markmcgookin/pico-gps-datalogger/Case/Manufacturing/NewSwitchMount.stl

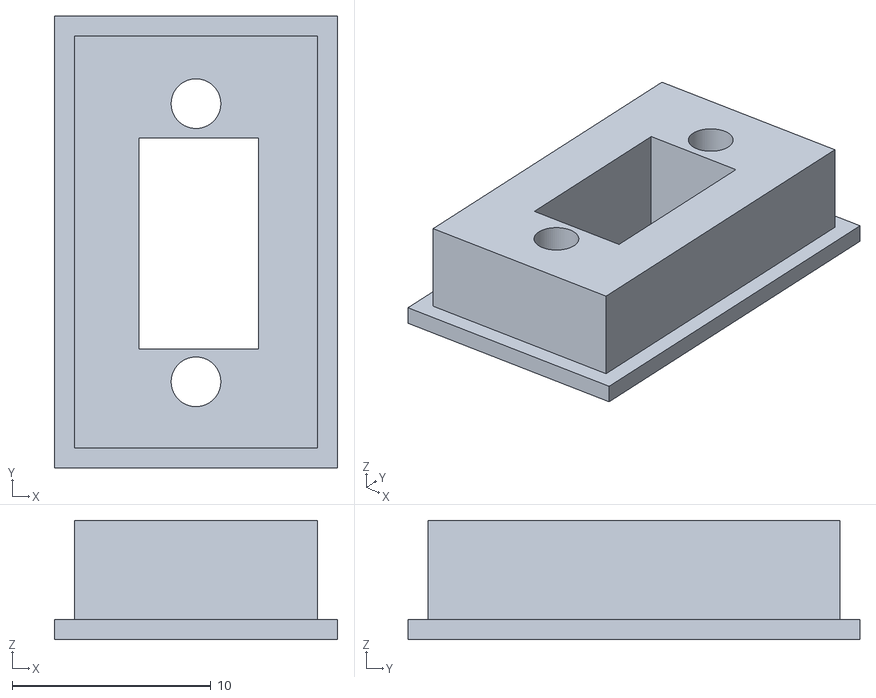
[picture p1: CAD file, 2023-01-19]
Case/Manufacturing/NewSwitchMount.stl
14.2 x 22.8 x 6.00
