markmcgookin/pico-gps-datalogger/Case/Manufacturing/ChargerMount.stl

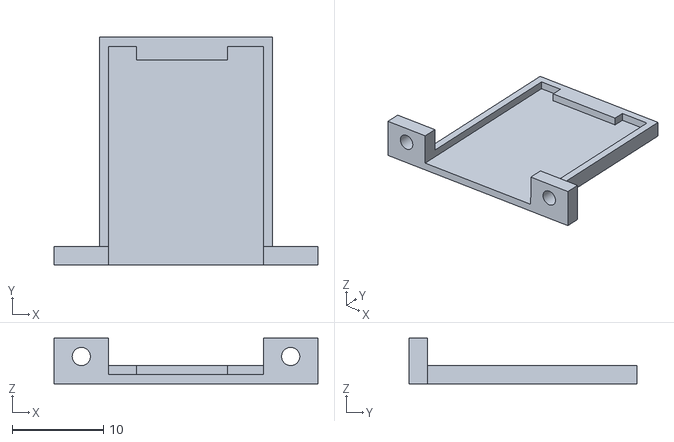
[picture p2: CAD file, 2023-01-19]
Case/Manufacturing/ChargerMount.stl
29.0 x 25.0 x 5.00
