markmcgookin/pico-gps-datalogger/Case/Manufacturing/Lid-Expanded.stl

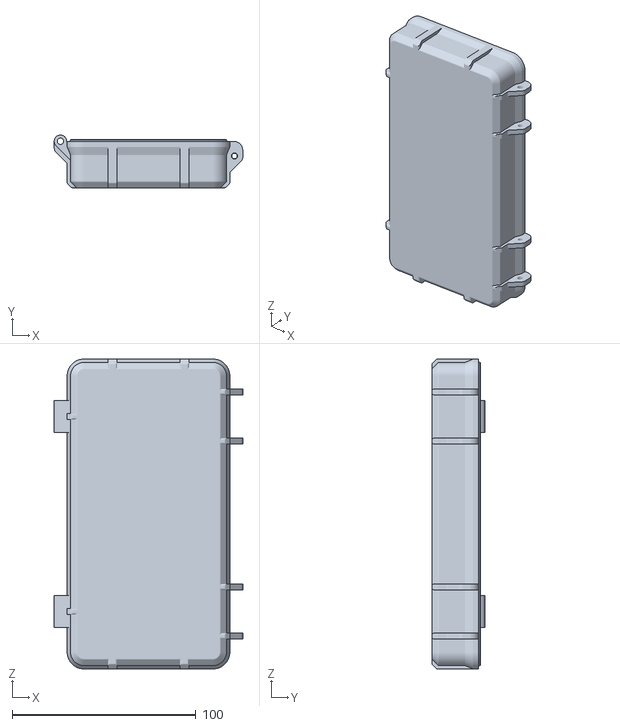
[picture p3: CAD file, 2023-01-19]
Case/Manufacturing/Lid-Expanded.stl
102.5 x 28.8 x 168.5
