markmcgookin/pico-gps-datalogger/Case/Manufacturing/Box-Expanded.stl

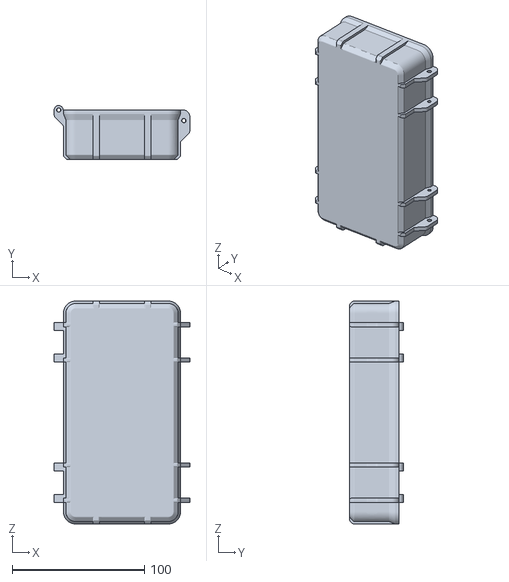
[picture p4: CAD file, 2023-01-19]
Case/Manufacturing/Box-Expanded.stl
102.5 x 40.8 x 168.5
