markmcgookin/pico-gps-datalogger/Case/Manufacturing/Insert-Expanded-PowerSwitch.stl

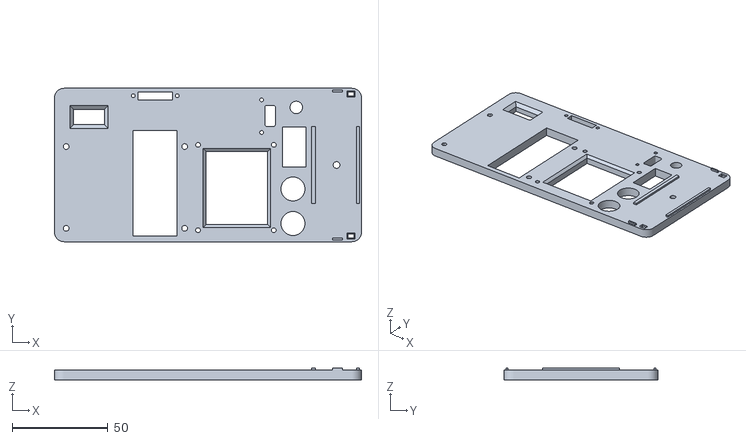
[picture p5: CAD file, 2023-01-19]
Case/Manufacturing/Insert-Expanded-PowerSwitch.stl
160.0 x 80.0 x 6.00
