markmcgookin/pico-gps-datalogger/Case/Manufacturing/Box Latch.stl

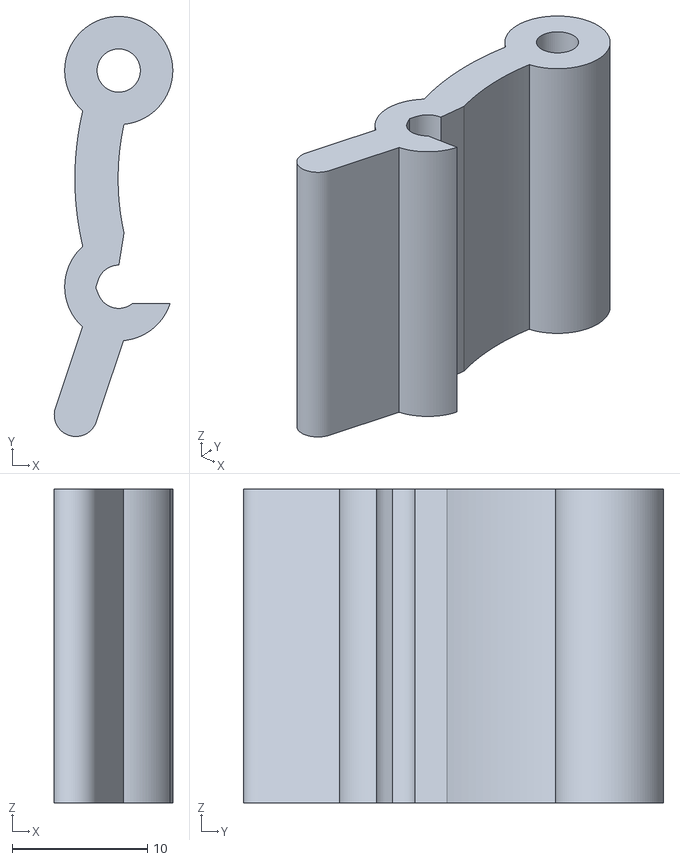
[picture p6: CAD file, 2023-01-19]
Case/Manufacturing/Box Latch.stl
8.77 x 31.1 x 23.2
