markmcgookin/pico-gps-datalogger/(list of files, cad)

Other CAD files:
Case/3D Modeling/Rugged Box v55.f3d
