markmcgookin/pico-gps-datalogger/board-design/pico-gps-datalogger/pico-gps-datalogger.kicad_pcb

## KiCad design board-design/pico-gps-datalogger/pico-gps-datalogger.kicad_pcb (2023-01-01)

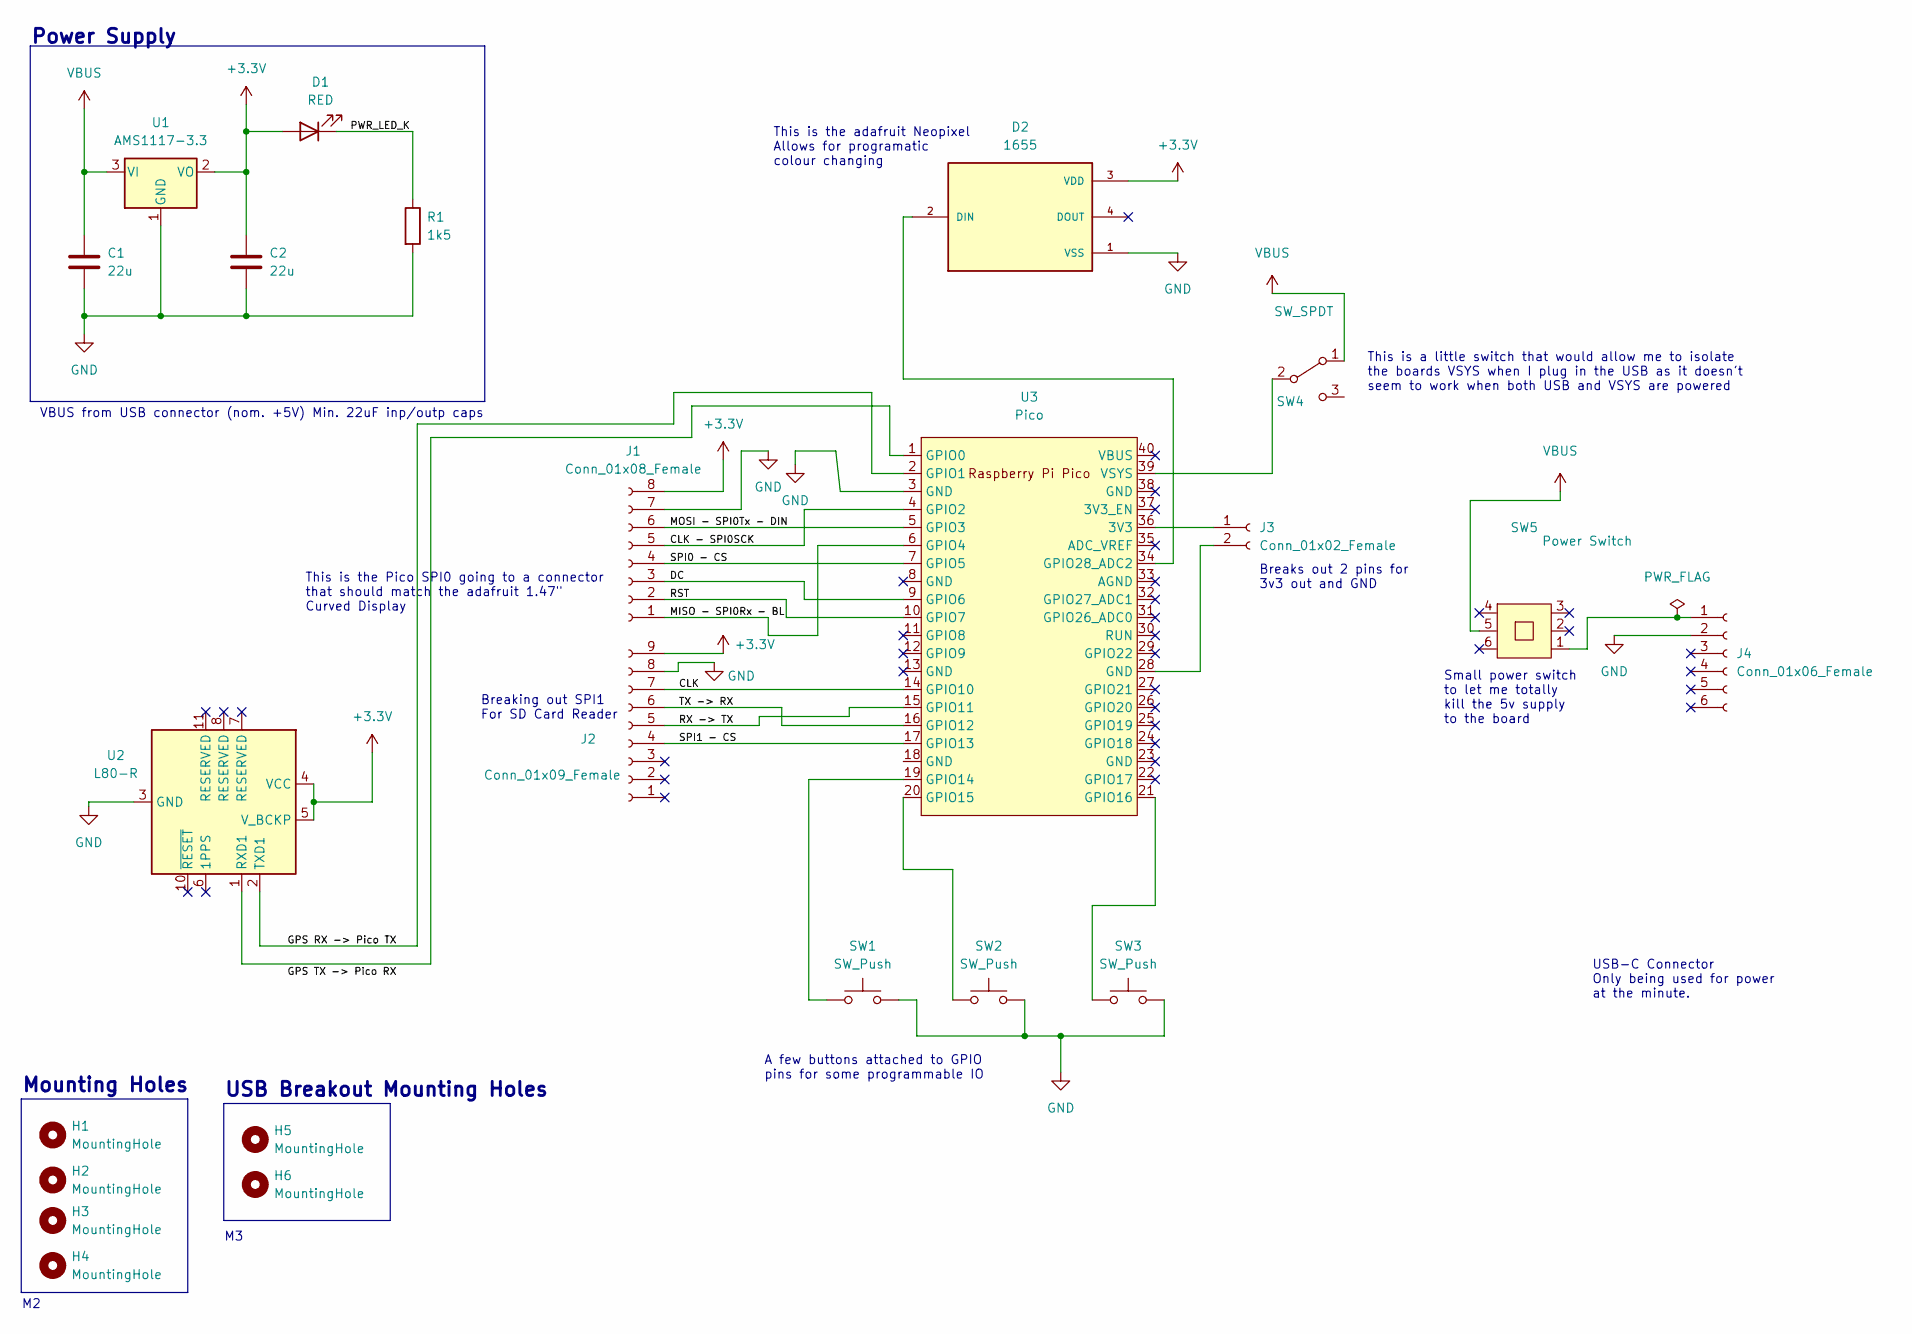
[picture p7: schematic pico-gps-datalogger.kicad_sch, RPI Pico - SPI Display with Neopixel - GPS and SD Card]

Parts:
C1, C2: 22u; C_0603_1608Metric
D1: RED; LED_0603_1608Metric
D2: 1655; LED_1655; PARTREV 01
H1, H2, H3, H4: MountingHole; MountingHole_2.2mm_M2
H5, H6: MountingHole; MountingHole_3.2mm_M3
J1: Conn_01x08_Female; JST_PH_B8B-PH-K_1x08_P2.00mm_Vertical
J2: Conn_01x09_Female; PinHeader_1x09_P2.54mm_Vertical
J3: Conn_01x02_Female; PinHeader_1x02_P2.54mm_Vertical
J4: Conn_01x06_Female; PinHeader_1x06_P2.54mm_Vertical
R1: 1k5; R_0603_1608Metric
SW1, SW2, SW3: SW_Push; SW_PUSH_6mm_H5mm
SW4: SW_SPDT; SW_SPDT_PCM12
SW5: Power Switch; SW_DPDT_XLX
U1: AMS1117-3.3; SOT-223-3_TabPin2
U2: L80-R; Quectel_L80-R
U3: Pico; RPi_Pico_SMD_TH

Connections:
+3.3V: C2.1, D1.2 (A), D2.3 (VDD), J1.8, J2.9, U1.2 (VO), U2.4 (VCC), U2.5 (V_BCKP)
/CLK: J2.7, U3.14 (GPIO10)
/CLK - SPI0SCK: J1.5, U3.4 (GPIO2)
/DC: J1.3, U3.9 (GPIO6)
/GPS RX -> Pico TX: U2.2 (TXD1), U3.2 (GPIO1)
/MISO - SPI0Rx - BL: J1.1, U3.6 (GPIO4)
/MOSI - SPI0Tx - DIN: J1.6, U3.5 (GPIO3)
/PWR_LED_K: D1.1 (K), R1.1
/RST: J1.2, U3.10 (GPIO7)
/RX -> TX: J2.5, U3.15 (GPIO11)
/SPI0 - CS: J1.4, U3.7 (GPIO5)
/SPI1 - CS: J2.4, U3.17 (GPIO13)
/TX -> RX: J2.6, U3.16 (GPIO12)
GND: C1.2, C2.2, D2.1 (VSS), J1.7, J2.8, J4.2, R1.2, SW1.2, SW2.2, SW3.2, U1.1 (GND), U2.3 (GND), U2.12 (GND), U3.3 (GND)
unnamed: D2.2 (DIN), U3.34 (GPIO28_ADC2)
unnamed: J3.1, U3.36 (3V3)
unnamed: J3.2, U3.28 (GND)
unnamed: J4.1, SW5.1
unnamed: SW1.1, U3.19 (GPIO14)
unnamed: SW2.1, U3.20 (GPIO15)
unnamed: SW3.1, U3.21 (GPIO16)
unnamed: SW4.2 (B), U3.39 (VSYS)
unnamed: U2.1 (RXD1), U3.1 (GPIO0)
VBUS: C1.1, SW4.1 (A), SW5.5, U1.3 (VI)

Notes on the sheet:
A few buttons attached to GPIO pins for some programmable IO
Power Supply
Breaks out 2 pins for 3v3 out and GND
Mounting Holes
Small power switch to let me totally kill the 5v supply to the board
USB Breakout Mounting Holes
USB-C Connector Only being used for power at the minute.
Breaking out SPI1 For SD Card Reader
This is the adafruit Neopixel Allows for programatic colour changing
VBUS from USB connector (nom. +5V) Min. 22uF inp/outp caps
This is a little switch that would allow me to isolate the boards VSYS when I plug in the USB as it doesn't seem to work when both USB and VSYS are powered
This is the Pico SPI0 going to a connector that should match the adafruit 1.47" Curved Display

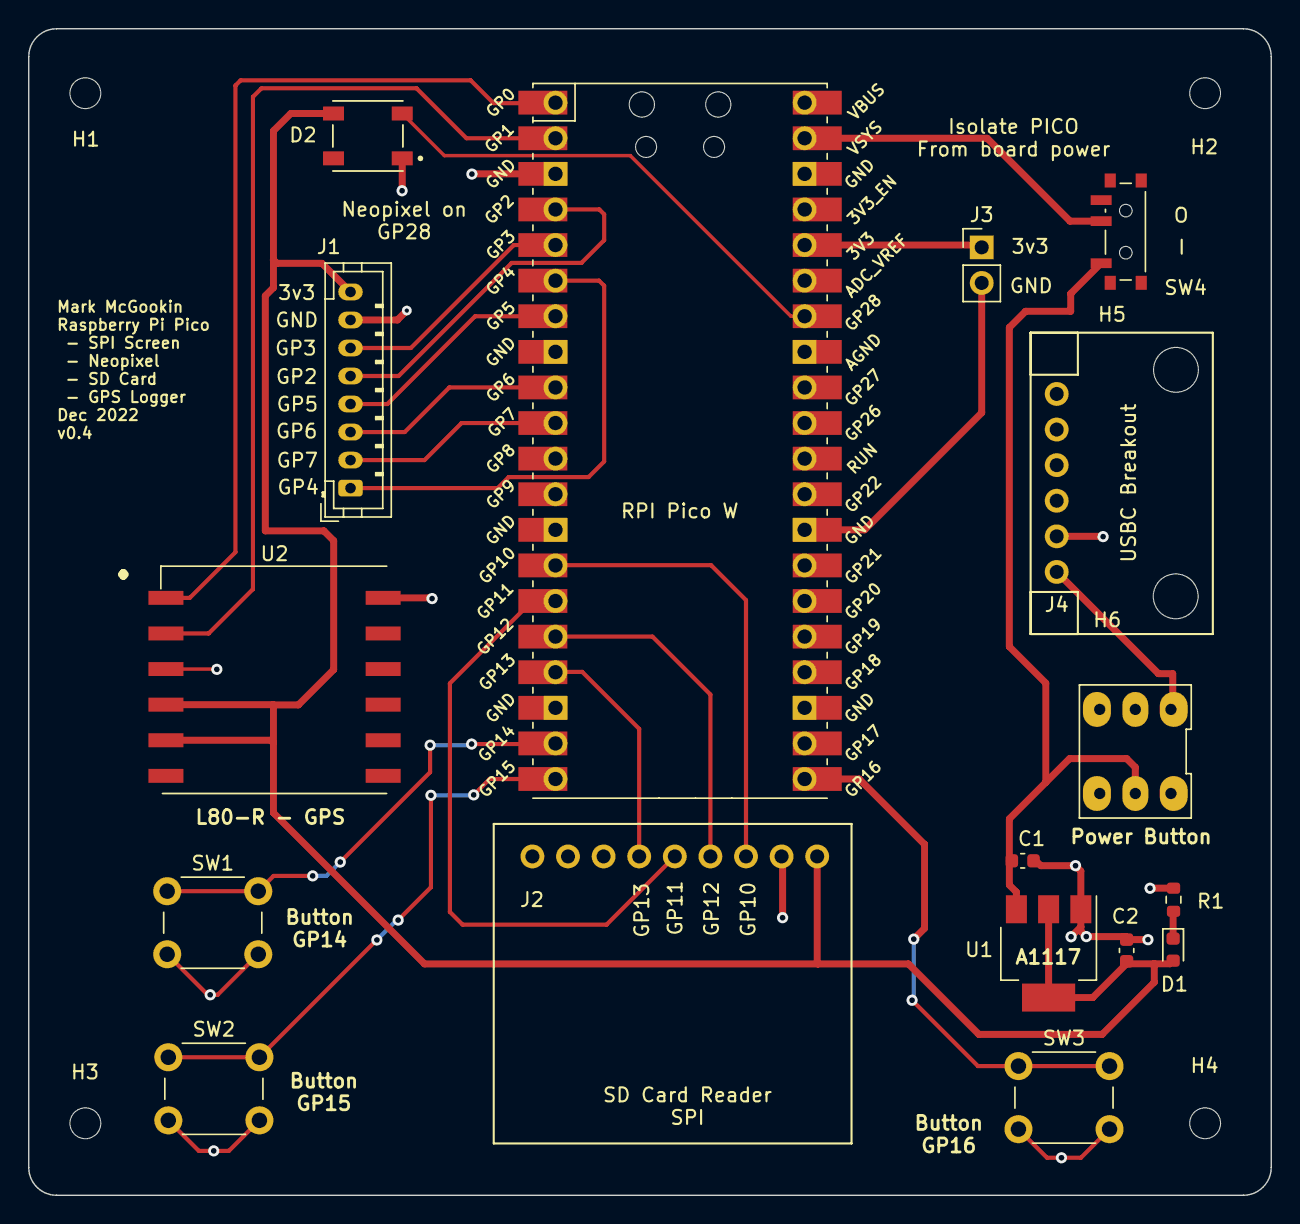
[picture p8: board pico-gps-datalogger.kicad_pcb from above]

Board: 2 copper layers, 88.7 x 83.2 mm, 23 parts (0 on the bottom side), 24 nets.
