markmcgookin/pico-gps-datalogger/device-code/waveshare-2.8/text_functions.py

def wrap_nicely(string, max_chars):
    string = string.replace('\n', '').replace('\r', '') # strip confusing newlines
    words = string.split(' ')
    the_lines = []
    the_line = ""
    for w in words:
        if len(the_line+' '+w) <= max_chars:
            the_line += ' '+w
        else:
            the_lines.append(the_line)
            the_line = w
    if the_line:
        the_lines.append(the_line)
    the_lines[0] = the_lines[0][1:]
    the_newline = ""
    for w in the_lines:
        the_newline += '\n'+w
    return the_newline
