markmcgookin/pico-gps-datalogger/ArduinoGPSTest/ArduinoGPSTest.ino

#include <TinyGPS++.h>
#include <SoftwareSerial.h>
#define rxGPS 3
#define txGPS 2
 
long lat, lon;
SoftwareSerial gpsSerial(rxGPS, txGPS);
TinyGPSPlus gps;
 
void setup()
{
  Serial.begin(9600); // connect serial
  gpsSerial.begin(9600); // connect gps sensor
}

int count = 0;
void loop()
{
  while (gpsSerial.available())     // check for gps data
  {
    if (gps.encode(gpsSerial.read()))   // encode gps data
    {
      Serial.print("Count: ");
      Serial.print(count);
      Serial.println(" ");
      count++;

      Serial.print("SATS: ");
      Serial.println(gps.satellites.value());
      Serial.print("LAT: ");
      Serial.println(gps.location.lat(), 6);
      Serial.print("LONG: ");
      Serial.println(gps.location.lng(), 6);
      Serial.print("ALT: ");
      Serial.println(gps.altitude.meters());
      Serial.print("SPEED: ");
      Serial.println(gps.speed.mps());
 
      Serial.print("Date: ");
      Serial.print(gps.date.day()); Serial.print("/");
      Serial.print(gps.date.month()); Serial.print("/");
      Serial.println(gps.date.year());
 
      Serial.print("Hour: ");
      Serial.print(gps.time.hour()); Serial.print(":");
      Serial.print(gps.time.minute()); Serial.print(":");
      Serial.println(gps.time.second());
      Serial.println("---------------------------");
      delay(4000);
    }
  }
}
