markmcgookin/pico-gps-datalogger/(commit log)

2022-12-25 Got a working pico GPS reader (no logging yet) just prints
2022-12-28 added board design, gerbers, step file etc
    [pico-gps-datalogger.kicad_pcb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]
2022-12-28 updated pcb a bit, to power pico with 5v not 3v3 as it doesn't seem to like that. Added datasheet for GPS.
    [pico-gps-datalogger.kicad_pcb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]
2023-01-01 updated design files again for rear copper on power switch
    [pico-gps-datalogger.kicad_pcb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]
2023-01-11 added waveshare device version
2023-01-15 Working before mode change switch development
2023-01-15 Got the mode switch working.... will reboot to change modes
    [code.py, rungps.py, runwebserver.py]
2023-01-15 Added web server mode when switched to bottom.
2023-01-19 Added commented out code to show buttons
2023-01-19 Updated for buttons
2023-01-19 Added files for case design
    [Box Latch.stl, Box-Expanded.stl, ChargerMount.stl, Insert-Expanded-PowerSwitch.stl, Lid-Expanded.stl, NewSwitchMount.stl, Rugged Box v55.f3d]
